SovGVD/esp32-robot-dog-code/(commit log)

2021-03-21 WIP: Updare big robot dog code to use only ESP32
2021-03-23 Tools to calibrate servo
2021-03-23 Use custom servo profile
2021-03-27 Docs: some instuctions for servo and leg calibration
2021-04-03 update IMU lib, add INA219 lib, but it (and any others) does not work as expected, device just reboot
    [HAL.ino, cli.ino, cliGet.ino, config.h, def.h, imu.ino, powerSensor.ino, robot_dog_esp32.ino]
2021-04-03 fix power meausuer
    I ran command that call I2C on Core0, while I2C has been init on Core1 :facepalm:
    [cliGet.ino, powerSensor.ino, robot_dog_esp32.ino]
2021-04-03 i2c in service loop
2021-04-06 IK_simple fix, rotation fix
    [cliGet.ino, config_small.h, gait.ino, robot_dog_esp32.ino]
2021-04-08 Telemetry: display power sensor data and loop time in robot gui
2021-04-09 Telemetry: display power sensor data and loop time in robot gui, part2
2021-04-13 improve loop and robot stability
    [config.h, config_small.h, gait.ino]
2021-12-03 move webserver to service task, this should prevent some servo issues
    [WiFi.ino, robot_dog_esp32.ino]
